Lucianobianchi/ALPI-bot/README.md

# ALPI-bot
Code for a patient-follower oxygen-tube-holder robot

# Media
* https://www.youtube.com/watch?v=FxIlZGT8ktU
