Lucianobianchi/ALPI-bot/ICRA2022/images/alpibot2.jpg

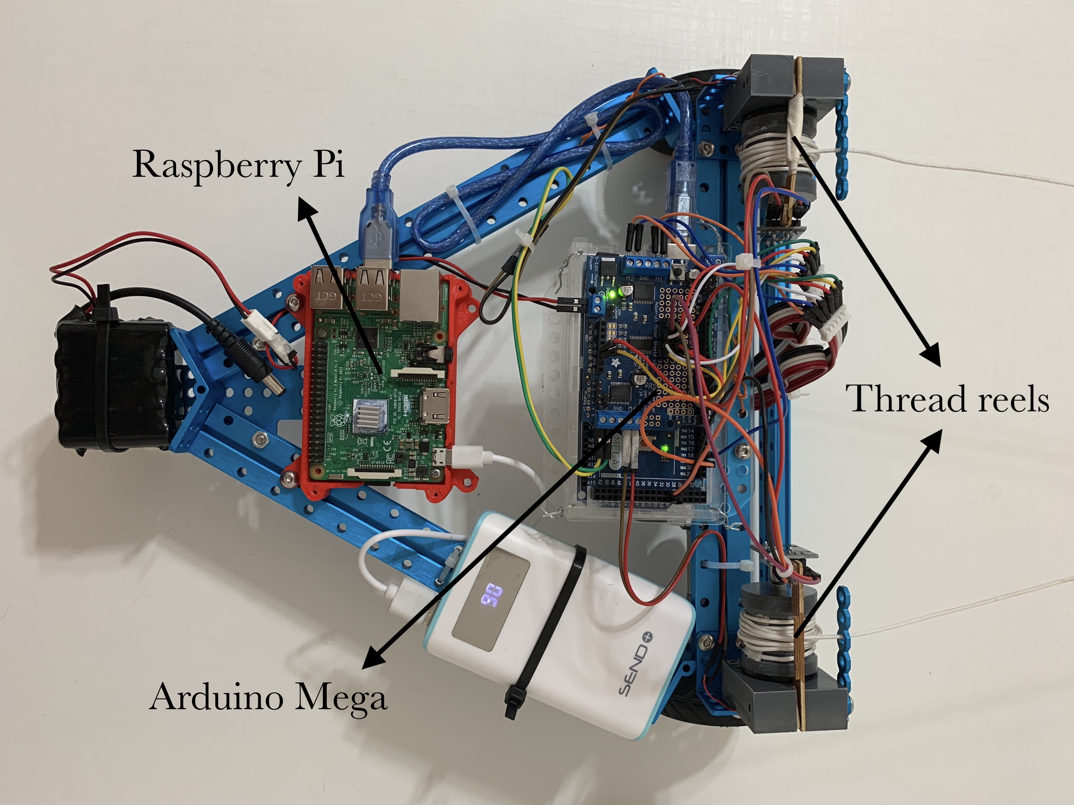
ICRA2022/images/alpibot2.jpg
