Lucianobianchi/ALPI-bot/ICRA2022/images/alpibot3.jpg

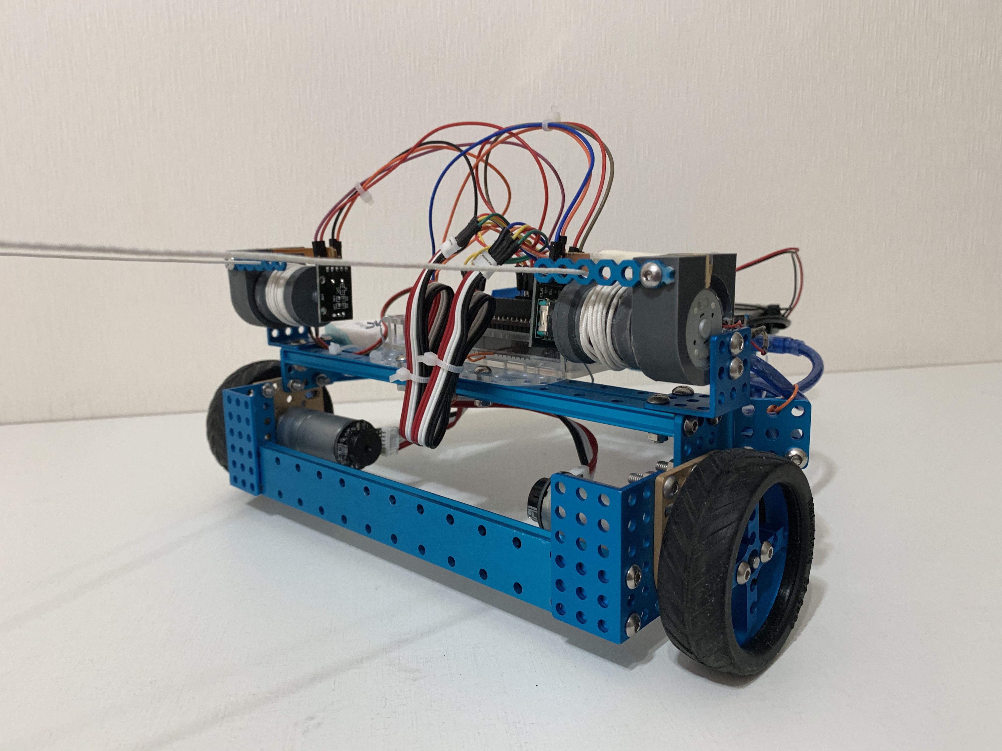
ICRA2022/images/alpibot3.jpg
