Lucianobianchi/ALPI-bot/ICRA2022/images/capture.png

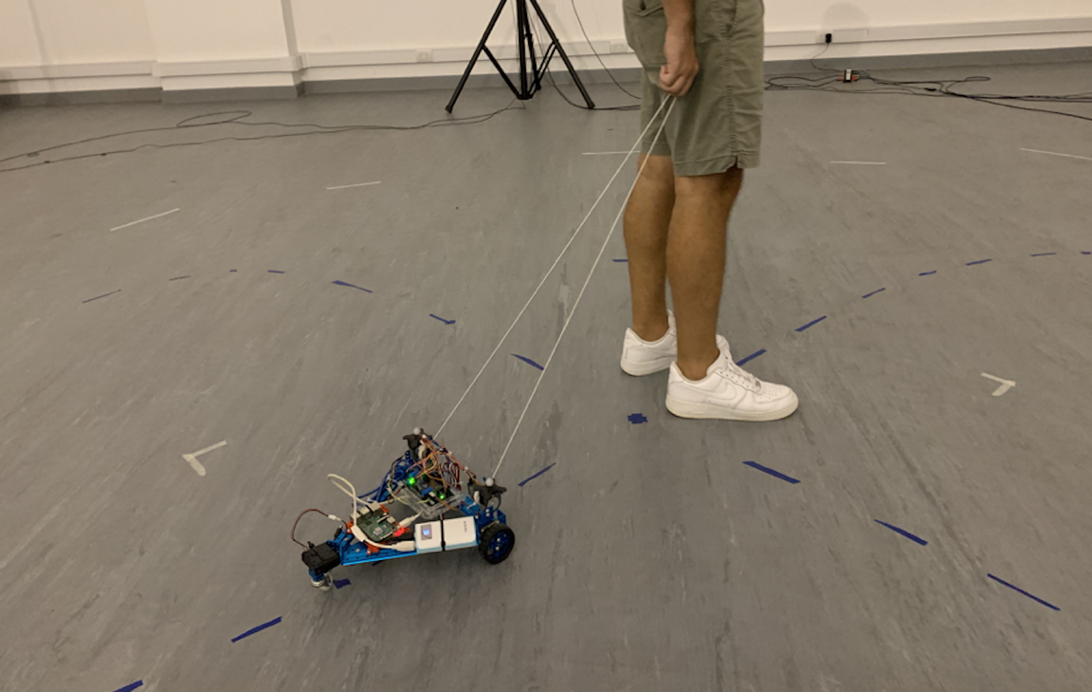
ICRA2022/images/capture.png
