Lucianobianchi/ALPI-bot/ICRA2022/images/dibujito.jpg

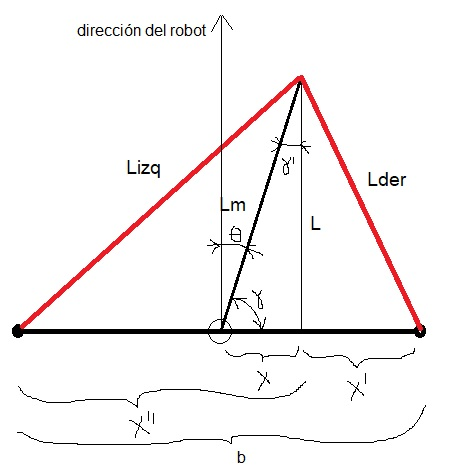
ICRA2022/images/dibujito.jpg
