Lucianobianchi/ALPI-bot/results/captura.csv

Frame | time | X1 | Y1 | Z1 | X2 | Y2 | Z2 | X3 | Y3 | Z3
0 | 0 | -0.180618 | 0.149802 | -0.159743 | -0.039086 | 0.150296 | -0.347928 | 0.085621 | 0.764084 | 0.075863
1 | 0.01 | -0.179731 | 0.149818 | -0.159161 | -0.038237 | 0.150239 | -0.347206 | 0.086371 | 0.764374 | 0.078371
2 | 0.02 | -0.178906 | 0.149811 | -0.158637 | -0.037356 | 0.150188 | -0.34662 | 0.087247 | 0.764664 | 0.080828
3 | 0.03 | -0.178171 | 0.149652 | -0.158014 | -0.036412 | 0.150135 | -0.346009 | 0.088232 | 0.765296 | 0.083106
4 | 0.04 | -0.177268 | 0.149736 | -0.15747 | -0.035564 | 0.150104 | -0.345337 | 0.088814 | 0.765545 | 0.085977
5 | 0.05 | -0.17668 | 0.149711 | -0.156868 | -0.034716 | 0.150145 | -0.344669 | 0.089467 | 0.765579 | 0.088579
6 | 0.06 | -0.175925 | 0.149715 | -0.156197 | -0.033912 | 0.150182 | -0.344029 | 0.090357 | 0.765594 | 0.091325
7 | 0.07 | -0.174991 | 0.149817 | -0.155674 | -0.032999 | 0.150196 | -0.343338 | 0.091239 | 0.765832 | 0.093876
8 | 0.08 | -0.174147 | 0.149788 | -0.15504 | -0.032201 | 0.15016 | -0.342742 | 0.091903 | 0.765651 | 0.096737
9 | 0.09 | -0.17326 | 0.149736 | -0.154454 | -0.031267 | 0.150077 | -0.342049 | 0.092629 | 0.765641 | 0.0995
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
