Lucianobianchi/ALPI-bot/results/ft1cap.csv

Frame | time | X1 | Y1 | Z1 | X2 | Y2 | Z2 | X3 | Y3 | Z3
0 | 0.000000 | -0.434678 | 0.148953 | -0.275421 | -0.272182 | 0.149450 | -0.434331 | -0.014920 | 0.797898 | -0.036347
1 | 0.010000 | -0.434674 | 0.148948 | -0.275332 | -0.272176 | 0.149452 | -0.434355 | -0.014467 | 0.797473 | -0.036503
2 | 0.020000 | -0.434612 | 0.148909 | -0.275391 | -0.272175 | 0.149463 | -0.434340 | -0.013977 | 0.796954 | -0.036535
3 | 0.030000 | -0.434775 | 0.148986 | -0.275376 | -0.272140 | 0.149455 | -0.434342 | -0.013357 | 0.796352 | -0.036459
4 | 0.040000 | -0.434637 | 0.148950 | -0.275362 | -0.272135 | 0.149460 | -0.434333 | -0.012852 | 0.795869 | -0.036396
5 | 0.050000 | -0.434745 | 0.148960 | -0.275359 | -0.272147 | 0.149466 | -0.434325 | -0.012354 | 0.795366 | -0.036291
6 | 0.060000 | -0.434769 | 0.149004 | -0.275389 | -0.272149 | 0.149454 | -0.434351 | -0.011882 | 0.794853 | -0.036125
7 | 0.070000 | -0.434763 | 0.149023 | -0.275263 | -0.272165 | 0.149459 | -0.434372 | -0.011370 | 0.794316 | -0.035949
8 | 0.080000 | -0.434809 | 0.149055 | -0.275272 | -0.272149 | 0.149448 | -0.434354 | -0.010820 | 0.793789 | -0.035705
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
