Lucianobianchi/ALPI-bot/results/ft2cap.csv

Frame | time | X1 | Y1 | Z1 | X2 | Y2 | Z2 | X3 | Y3 | Z3
0 | 0.000000 | -0.013792 | 0.795537 | -0.005392 | -0.262817 | 0.149606 | -0.441182 | -0.420167 | 0.149053 | -0.276823
1 | 0.010000 | -0.013768 | 0.795497 | -0.005401 | -0.262802 | 0.149616 | -0.441184 | -0.420188 | 0.149013 | -0.276834
2 | 0.020000 | -0.013742 | 0.795481 | -0.005458 | -0.262798 | 0.149607 | -0.441184 | -0.420162 | 0.149029 | -0.276811
3 | 0.030000 | -0.013743 | 0.795458 | -0.005463 | -0.262809 | 0.149618 | -0.441205 | -0.420177 | 0.149027 | -0.276847
4 | 0.040000 | -0.013751 | 0.795421 | -0.005500 | -0.262798 | 0.149611 | -0.441200 | -0.420168 | 0.149038 | -0.276818
5 | 0.050000 | -0.013747 | 0.795385 | -0.005521 | -0.262805 | 0.149624 | -0.441191 | -0.420160 | 0.149050 | -0.276822
6 | 0.060000 | -0.013718 | 0.795366 | -0.005581 | -0.262800 | 0.149610 | -0.441191 | -0.420170 | 0.149039 | -0.276813
7 | 0.070000 | -0.013707 | 0.795362 | -0.005634 | -0.262794 | 0.149620 | -0.441181 | -0.420169 | 0.149028 | -0.276828
8 | 0.080000 | -0.013692 | 0.795355 | -0.005692 | -0.262809 | 0.149628 | -0.441186 | -0.420176 | 0.149032 | -0.276844
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
