Lucianobianchi/ALPI-bot/results/ftfreecap.csv

Frame | time | X1 | Y1 | Z1 | X2 | Y2 | Z2 | X3 | Y3 | Z3
0 | 0 | 1.517467 | 0.145197 | 1.789625 | 1.42515 | 0.77084 | 1.375074 | 1.677469 | 0.144225 | 1.628538
1 | 0.01 | 1.517434 | 0.145158 | 1.789608 | 1.423414 | 0.771289 | 1.373166 | 1.677499 | 0.144227 | 1.628505
2 | 0.02 | 1.517466 | 0.145129 | 1.789555 | 1.421671 | 0.771852 | 1.371197 | 1.677505 | 0.144237 | 1.628559
3 | 0.03 | 1.518189 | 0.145174 | 1.789954 | 1.420011 | 0.772247 | 1.369382 | 1.677542 | 0.144213 | 1.628625
4 | 0.04 | 1.517455 | 0.145098 | 1.789641 | 1.4182 | 0.772701 | 1.367232 | 1.677503 | 0.144229 | 1.628655
5 | 0.05 | 1.518187 | 0.14517 | 1.789975 | 1.416354 | 0.773068 | 1.365366 | 1.67747 | 0.144228 | 1.628619
6 | 0.06 | 1.517483 | 0.145118 | 1.78963 | 1.41467 | 0.773363 | 1.36347 | 1.677445 | 0.144238 | 1.628625
7 | 0.07 | 1.51748 | 0.145086 | 1.789654 | 1.412954 | 0.773723 | 1.361353 | 1.677552 | 0.144157 | 1.62868
8 | 0.08 | 1.517492 | 0.145129 | 1.789626 | 1.411081 | 0.774009 | 1.359473 | 1.677526 | 0.144264 | 1.628622
9 | 0.09 | 1.517488 | 0.145106 | 1.789593 | 1.409584 | 0.774379 | 1.357634 | 1.677657 | 0.144468 | 1.628792
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
