Lucianobianchi/ALPI-bot/results/rg1cap.csv

Frame | time | X1 | Y1 | Z1 | X2 | Y2 | Z2 | X3 | Y3 | Z3
0 | 0.000000 | -0.428134 | 0.149122 | -0.279280 | -0.264046 | 0.149517 | -0.436970 | -0.007651 | 0.782518 | 0.000271
1 | 0.010000 | -0.428122 | 0.149105 | -0.279263 | -0.264073 | 0.149523 | -0.436997 | -0.007670 | 0.782429 | 0.000744
2 | 0.020000 | -0.428125 | 0.149119 | -0.279259 | -0.264074 | 0.149509 | -0.436992 | -0.007689 | 0.782334 | 0.001221
3 | 0.030000 | -0.428140 | 0.149097 | -0.279259 | -0.264069 | 0.149495 | -0.436974 | -0.007651 | 0.782230 | 0.001706
4 | 0.040000 | -0.428126 | 0.149104 | -0.279261 | -0.264038 | 0.149511 | -0.436977 | -0.007543 | 0.782016 | 0.002247
5 | 0.050000 | -0.428108 | 0.149102 | -0.279256 | -0.264070 | 0.149497 | -0.436994 | -0.007312 | 0.781841 | 0.002832
6 | 0.060000 | -0.428128 | 0.149113 | -0.279279 | -0.264077 | 0.149523 | -0.437016 | -0.007029 | 0.781665 | 0.003437
7 | 0.070000 | -0.428167 | 0.149107 | -0.279303 | -0.264094 | 0.149509 | -0.437030 | -0.006621 | 0.781452 | 0.004121
8 | 0.080000 | -0.428177 | 0.149094 | -0.279275 | -0.264096 | 0.149506 | -0.437019 | -0.006141 | 0.781299 | 0.004732
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
