Lucianobianchi/ALPI-bot/results/rg2cap.csv

Frame | time | X1 | Y1 | Z1 | X2 | Y2 | Z2 | X3 | Y3 | Z3
0 | 0.000000 | -0.023116 | 0.794095 | -0.056948 | -0.262152 | 0.149474 | -0.438309 | -0.421609 | 0.149132 | -0.275842
1 | 0.010000 | -0.023058 | 0.794031 | -0.057110 | -0.262189 | 0.149482 | -0.438300 | -0.421611 | 0.149102 | -0.275831
2 | 0.020000 | -0.023006 | 0.794015 | -0.057298 | -0.262169 | 0.149477 | -0.438309 | -0.421613 | 0.149112 | -0.275832
3 | 0.030000 | -0.022980 | 0.793991 | -0.057462 | -0.262162 | 0.149477 | -0.438299 | -0.421610 | 0.149111 | -0.275840
4 | 0.040000 | -0.022928 | 0.793972 | -0.057621 | -0.262171 | 0.149487 | -0.438316 | -0.421602 | 0.149111 | -0.275832
5 | 0.050000 | -0.022920 | 0.793947 | -0.057779 | -0.262167 | 0.149486 | -0.438301 | -0.421609 | 0.149111 | -0.275832
6 | 0.060000 | -0.022924 | 0.793903 | -0.057919 | -0.262165 | 0.149477 | -0.438304 | -0.421483 | 0.149087 | -0.275849
7 | 0.070000 | -0.022931 | 0.793851 | -0.058054 | -0.262157 | 0.149483 | -0.438324 | -0.421599 | 0.149130 | -0.275856
8 | 0.080000 | -0.022964 | 0.793814 | -0.058159 | -0.262178 | 0.149485 | -0.438312 | -0.421612 | 0.149131 | -0.275841
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
