Lucianobianchi/ALPI-bot/results/media/full_scene.png

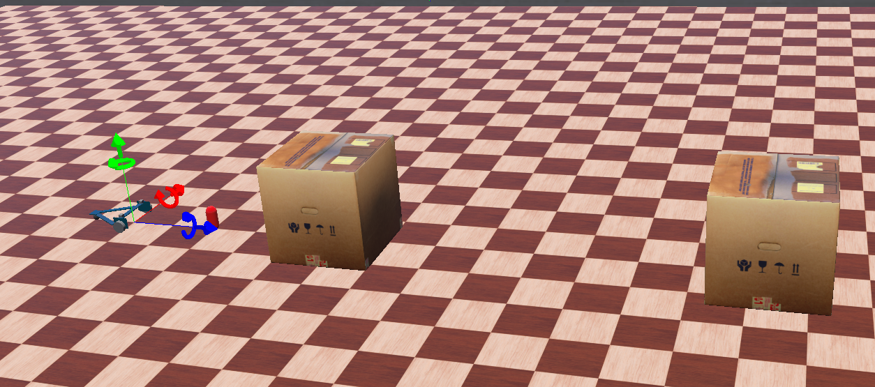
results/media/full_scene.png
