Lucianobianchi/ALPI-bot/results/media/robot.png

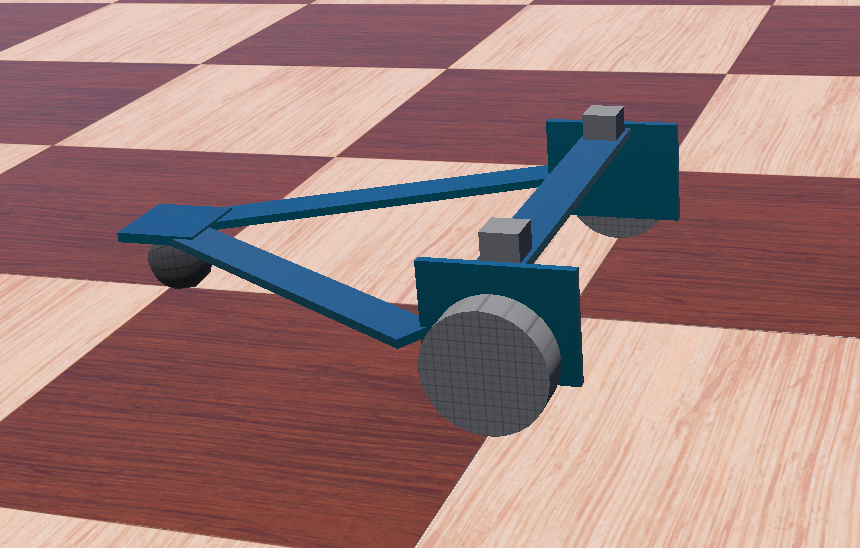
results/media/robot.png
