Lucianobianchi/ALPI-bot/results/media/robot_frente.png

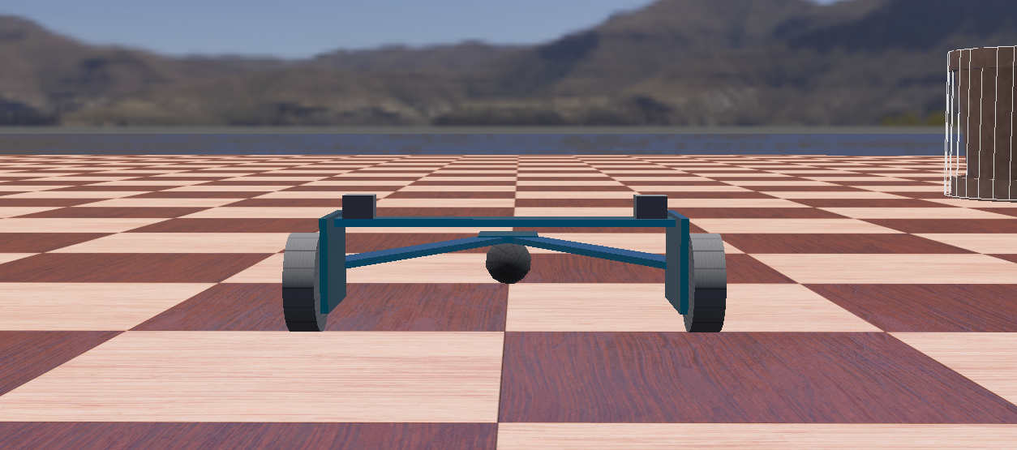
results/media/robot_frente.png
