Lucianobianchi/ALPI-bot/results/media/robot_side.png

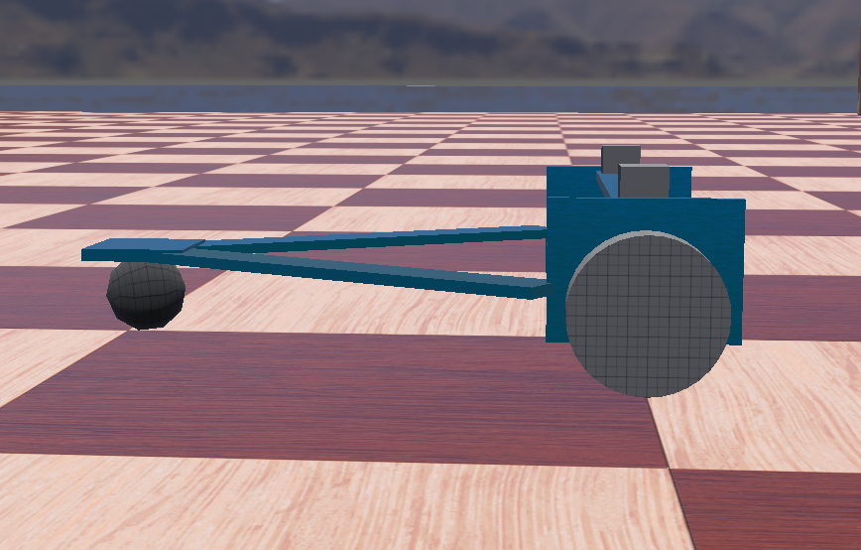
results/media/robot_side.png
