Lucianobianchi/ALPI-bot/results/media/robot_subject.png

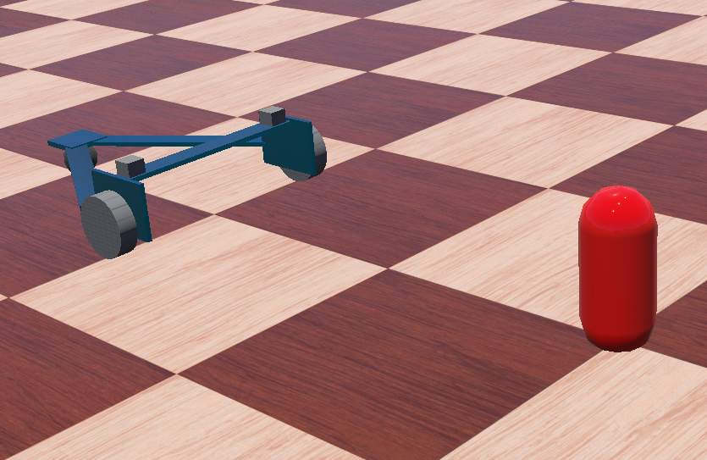
results/media/robot_subject.png
