Lucianobianchi/ALPI-bot/results/media/robot_top.png

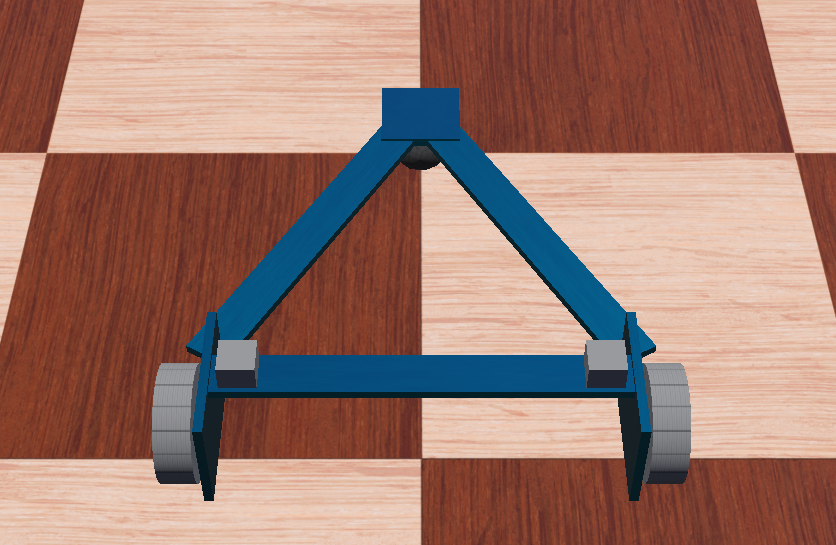
results/media/robot_top.png
