Lucianobianchi/ALPI-bot/results/media/start2.png

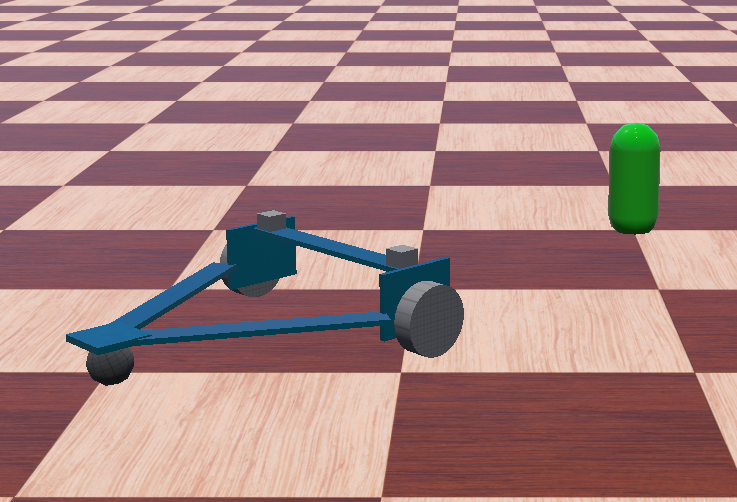
results/media/start2.png
