Lucianobianchi/ALPI-bot/results/media/start.png

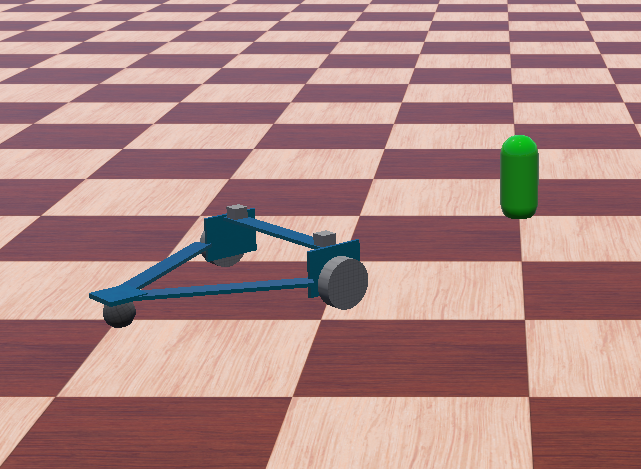
results/media/start.png
