Lucianobianchi/ALPI-bot/ICRA2022/images/cap_ft_vs_rg_dist-eps-converted-to.pdf

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

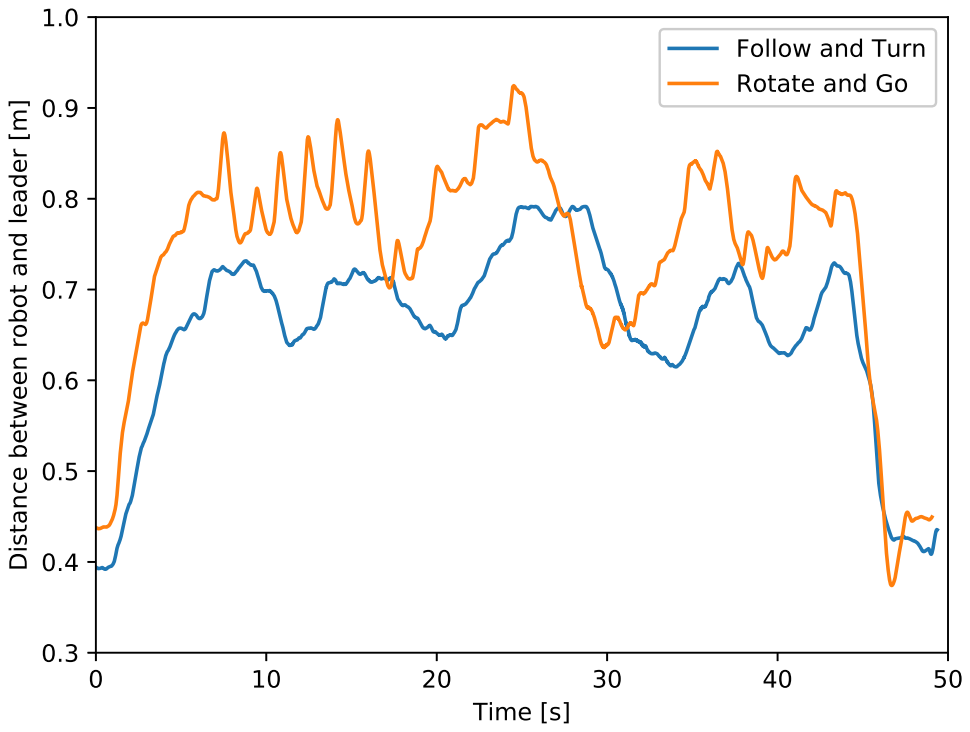
[picture p14: page 1]
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
