Lucianobianchi/ALPI-bot/ICRA2022/images/ft_a2_n1500_cv15_cr15-eps-converted-to.pdf

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

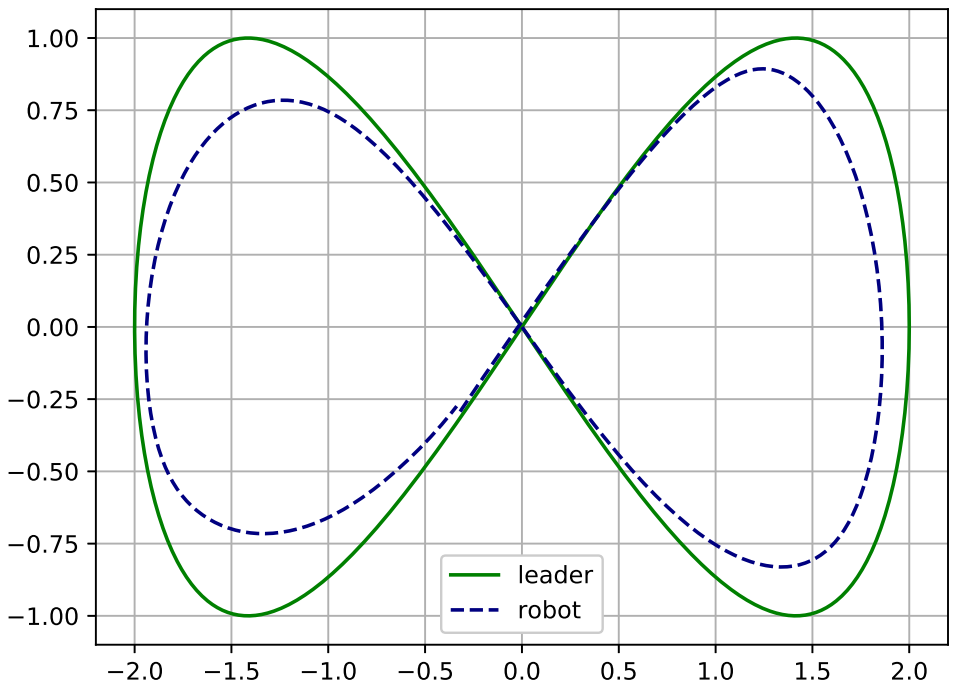
[picture p21: page 1]
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
