Lucianobianchi/ALPI-bot/ICRA2022/images/rg2cap_leader_robot_speed-eps-converted-to.pdf

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

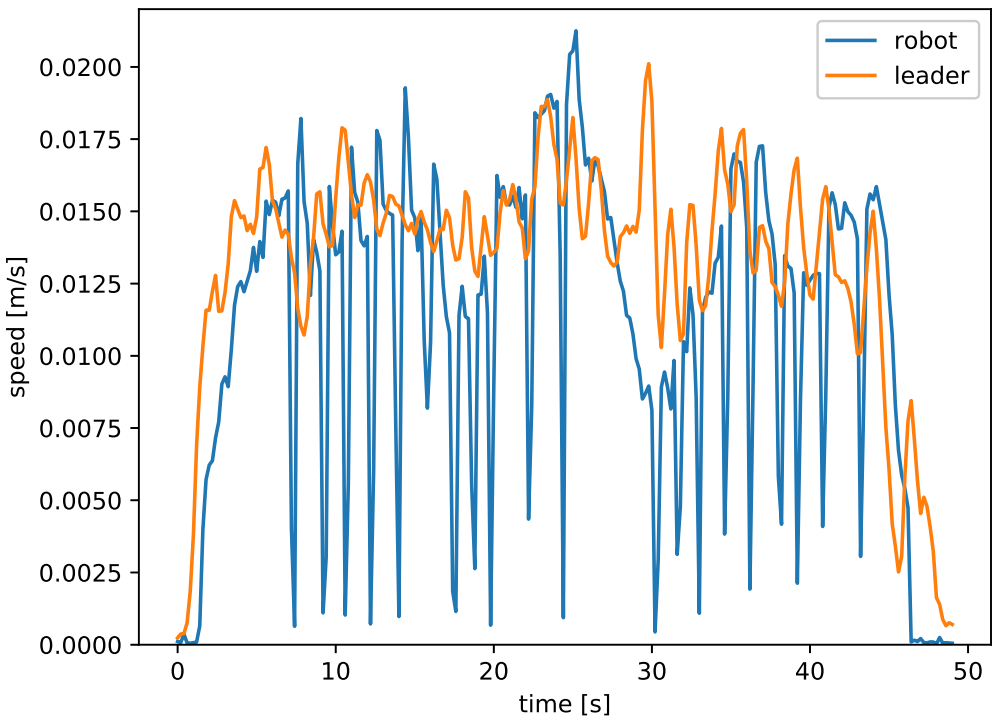
[picture p25: page 1]
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
