Lucianobianchi/ALPI-bot/ICRA2022/images/rg_cv20_cr20_bv10_dtoff10_leader_robot_speed-eps-converted-to.pdf

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

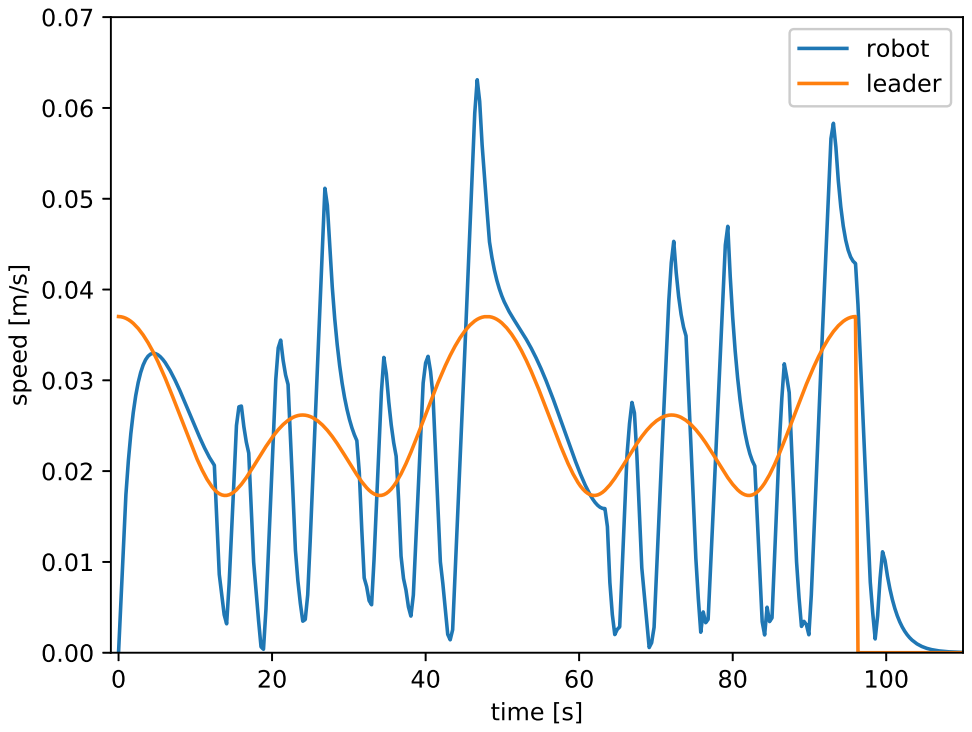
[picture p26: page 1]
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
