Lucianobianchi/ALPI-bot/ICRA2022/images/rgv_cv20_cr20_dr10-eps-converted-to.pdf

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

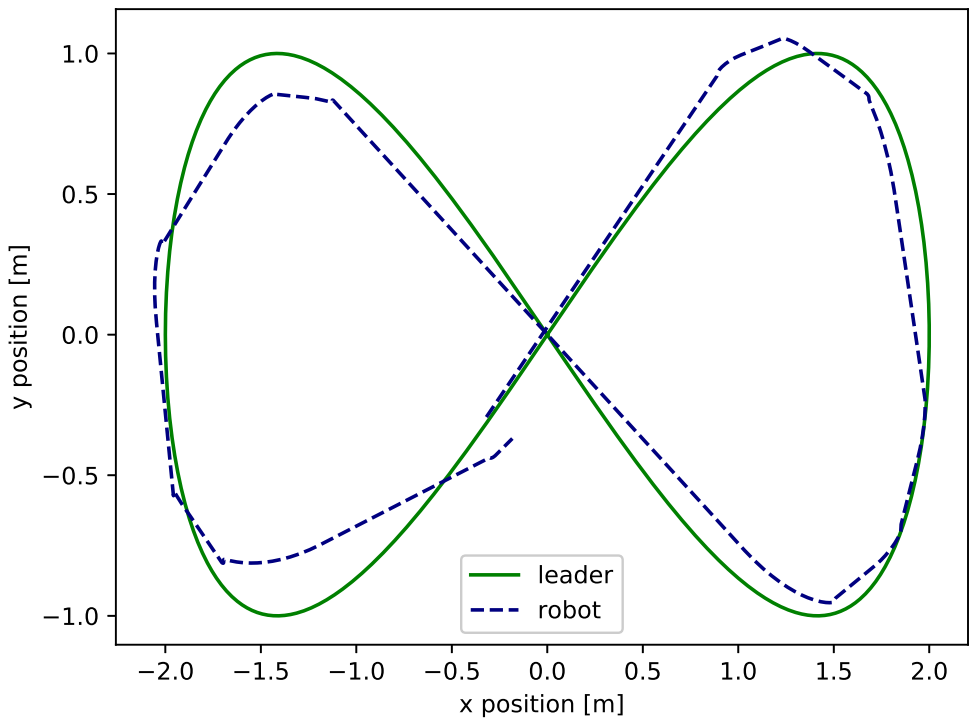
[picture p27: page 1]
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
