Lucianobianchi/ALPI-bot/ICRA2022/images/simulation_rotate-go-eps-converted-to.pdf

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

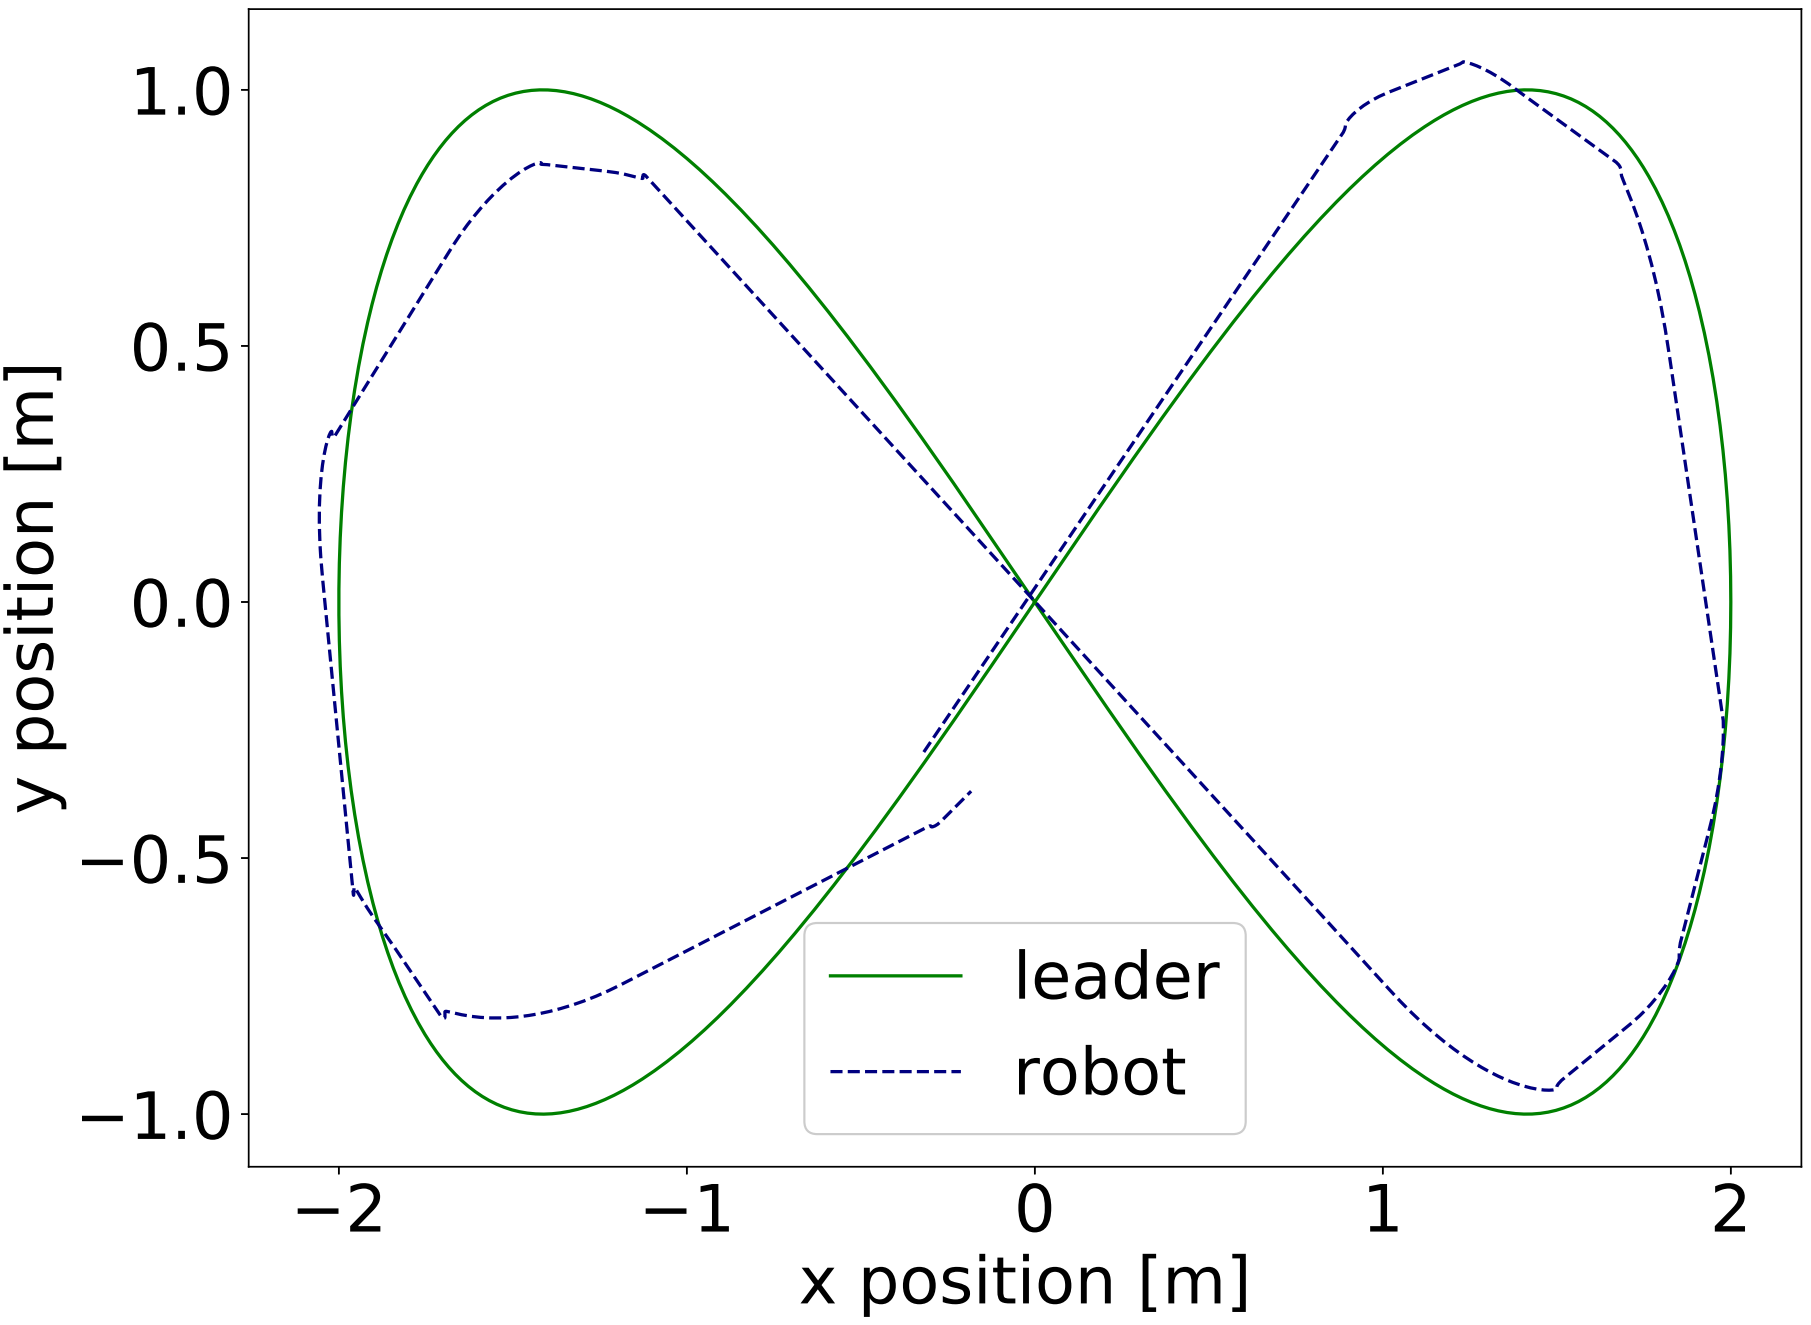
[picture p29: page 1]
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
