Lucianobianchi/ALPI-bot/ICRA2022/images/Wft_5.0kg_leader_robot_speed-eps-converted-to.pdf

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

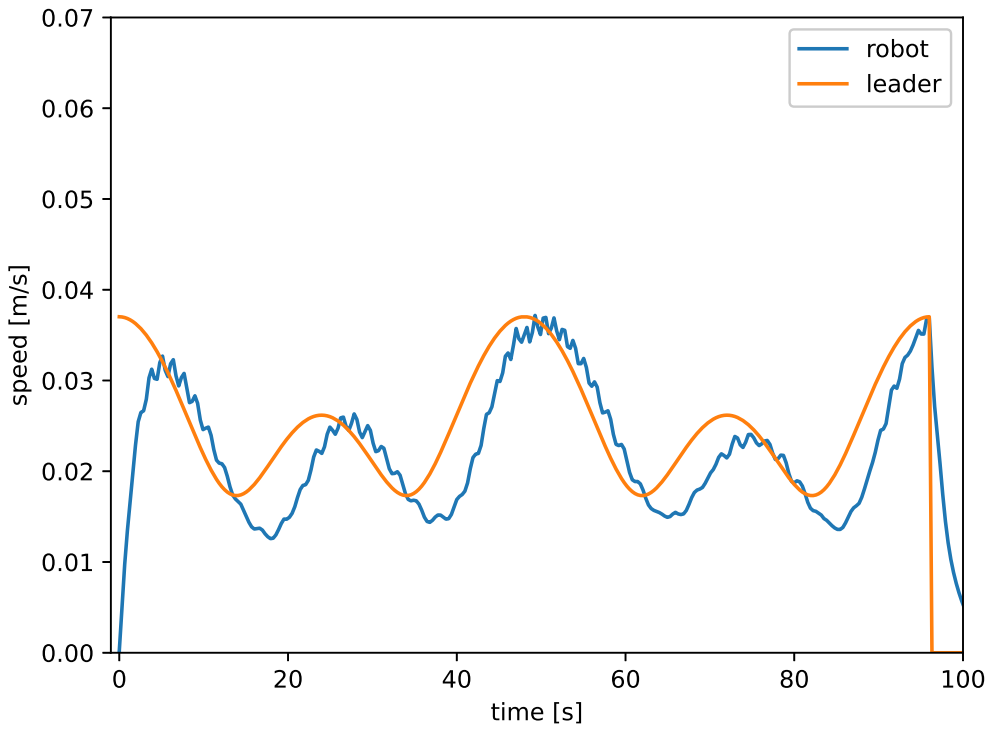
[picture p31: page 1]
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
