Lucianobianchi/ALPI-bot/(commit log)

2019-09-19 Ultrasonic in Brainstem
2019-12-17 Subo una nueva version del codigo de arduino para la nueva version del robot triangular. Tiene la parte de telemetria y tambien incluye el sensado y activacion de los encoders y los motores. Funciona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
2019-12-26 Diferentes clases migradas a python 3.5 que permiten operar sobre Arduino Mega con el shield de adafruit, y que acceden a la información para telemetría.
2019-12-27 Agrego archivos de configuracion para el linux box
2019-12-27 Agrego el video por PiCamera y H264.
2019-12-27 Actualizo el codigo ya corriendo en la RPi
2020-01-02 Added code to interrupt the running of the h264 process.
2020-01-09 opcodes de action en arduino ahora tienen 2 bytes para soportar mas comandos
2020-01-09 Brainstem usa los nuevos comandos serie para el arduino
2020-01-10 limpieza y refactor de algunas partes de brainstem y serialconnection
2020-01-11 mejoras en envio de data de sensores desde arduino
2020-01-14 plot thread lengths
2020-01-14 Mecanismo automatico para retraer los hilos, implementado en arduino
2020-01-14 mejoras mecanismo de hilos
2020-01-26 recuperacion de problemas de conexión con serie. Mas comandos para controlar el robot, ponerlo en modo autonomo
    [Brainstem.py, SerialConnection.py]
2020-01-28 archivos de la simulacion
2020-01-28 guardar datos de la trayectoria en la simulacion
    [sample.csv]
2020-01-31 jupyter notebooks to analyze data
    [sample.csv]
2020-01-31 lemniscata de gerono en la simulacion
    [sample.csv]
2020-01-31 correcciones en la posicion del robot en la simu
    [sample.csv]
2020-01-31 algunos test runs
    [t01.csv, t02.csv, t03.csv]
2020-02-03 control automatico en el robot con funciones de control
2020-02-03 bug fix control de motores arduino
    [Motor.ino]
2020-02-03 simulation data and media
    [ft_a2_n1500_cv10_cr15.csv, ft_a2_n1500_cv15_cr5.csv, ft_a2_n1500_cv5_cr20.csv, ft_a4_n3000_cv10_cr15.csv, ft_a4_n3000_cv15_cr5.csv, ft_a4_n3000_cv5_cr20.csv, rg_a2_n1500_cv20_cr20_bv10_dtoff05.csv, rg_a2_n1500_cv20_cr20_bv10_dtoff10.csv]
2020-02-03 algunas simulaciones mas
    [ft_a2_n1500_cv15_cr10.csv, ft_a2_n1500_cv15_cr15.csv, ft_a4_n3000_cv15_cr15.csv, rg_a2_n1500_cv20_dt075_cr15_basevr10.csv, rg_a2_n1500_cv20_dt10_cr20_basevr10.csv, rg_a4_n3000_cv20_cr20_bv10_dtoff05.csv, rg_a4_n3000_cv20_dt10_cr20_basevr05.csv, rg_a4_n3000_cv20_dt10_cr20_basevr10.csv]
2020-02-04 calculo de distancia para cada reel segu
2020-02-05 telemetry viewer completo y bug fix en to_motor_power
    [Brainstem.py, telemetry_viewer.py]
2020-02-05 guardar telemetria
    [captura.csv, hola.csv]
2020-02-05 multicast en brainstem
    [hola.csv]
2020-02-06 cambio de parametros
2020-02-07 mejoras al notebook de analisis de datos
    [ft1cap.csv, ftfreecap.csv, rg1cap.csv]
2020-02-10 Analisis de datos
    [ft2cap.csv, rg2cap.csv]
2020-02-11 mas simulation records para rg
    [rgv_cv10_cr20_dr10.csv, rgv_cv20_cr20_dr05.csv, rgv_cv20_cr20_dr10.csv, rgv_cv20_cr35_dr10.csv, rgv_cv20_cr5_dr05.csv, rgv_cv35_cr20_dr10.csv, rgv_cv5_cr20_dr10.csv]
2020-02-11 simulaciones corregidas
    [rgv_cv10_cr20_dr10.csv, rgv_cv20_cr20_dr05.csv, rgv_cv20_cr20_dr10.csv, rgv_cv20_cr35_dr10.csv, rgv_cv20_cr5_dr05.csv, rgv_cv35_cr20_dr10.csv, rgv_cv5_cr20_dr10.csv]
